adafruit/Adafruit-NAU7802-PCB/Adafruit NAU7802 Breakout.brd

## EAGLE design Adafruit NAU7802 Breakout.brd (2022-05-24)

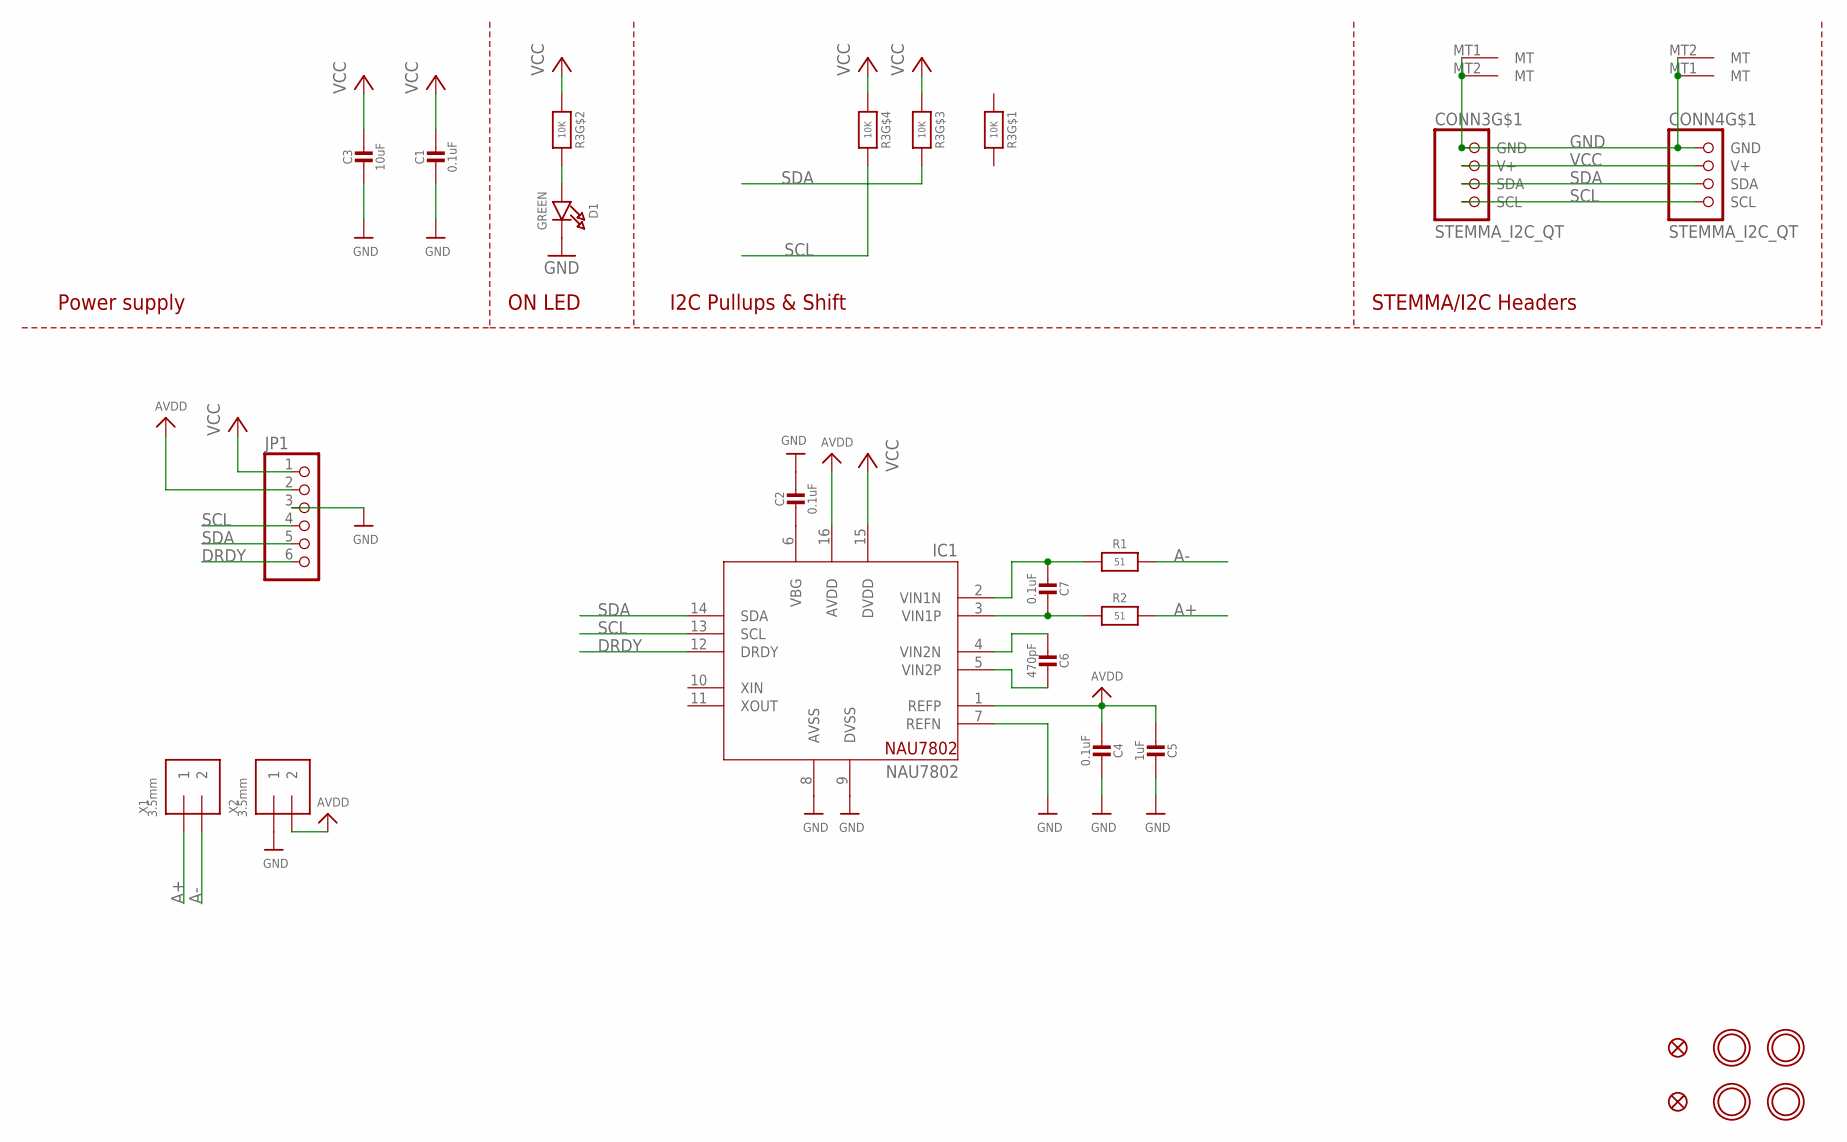
[picture p2: schematic Adafruit NAU7802 Breakout.sch]

Parts:
C1, C2, C4, C7: 0.1uF; 0603-NO
C3: 10uF; 0805-NO
C5: 1uF; 0603-NO
C6: 470pF; 0603-NO
CONN3, CONN4: STEMMA_I2C_QT; JST_SH4
D1: GREEN; CHIPLED_0603_NOOUTLINE
FID3, FID4: FIDUCIAL_1MM
IC1: NAU7802; SOIC16_NARROW
JP1: HEADER-1X670MIL; 1X06_ROUND_70
R1, R2: 51; 0603-NO
R3: 10K; RESPACK_4X0603
U$1, U$17, U$19, U$21: MOUNTINGHOLE2.5; MOUNTINGHOLE_2.5_PLATED
X1, X2: 3.5mm; TERMBLOCK_1X2-3.5MM

Connections:
A+: R2.2, X1.1
A-: R1.2, X1.2
AVDD: C4.2, C5.2, IC1.1 (REFP), IC1.16 (AVDD), JP1.2, X2.2
DRDY: IC1.12 (DRDY), JP1.6
GND: C1.2, C2.1, C3.2, C4.1, C5.1, CONN3.1 (GND), CONN3.MT1 (MT), CONN3.MT2 (MT), CONN4.1 (GND), CONN4.MT1 (MT), CONN4.MT2 (MT), D1.C, IC1.7 (REFN), IC1.8 (AVSS), IC1.9 (DVSS), JP1.3, X2.1
unnamed: D1.A, R3.7 (2)
unnamed: C2.2, IC1.6 (VBG)
unnamed: C6.2, IC1.4 (VIN2N)
unnamed: C6.1, IC1.5 (VIN2P)
unnamed: C7.1, IC1.3 (VIN1P), R2.1
unnamed: C7.2, IC1.2 (VIN1N), R1.1
SCL: CONN3.4 (SCL), CONN4.4 (SCL), IC1.13 (SCL), JP1.4, R3.5 (2)
SDA: CONN3.3 (SDA), CONN4.3 (SDA), IC1.14 (SDA), JP1.5, R3.6 (2)
VCC: C1.1, C3.1, CONN3.2 (V+), CONN4.2 (V+), IC1.15 (DVDD), JP1.1, R3.2 (1), R3.3 (1), R3.4 (1)

Notes on the sheet:
I2C Pullups & Shift
STEMMA/I2C Headers
ON LED
Power supply

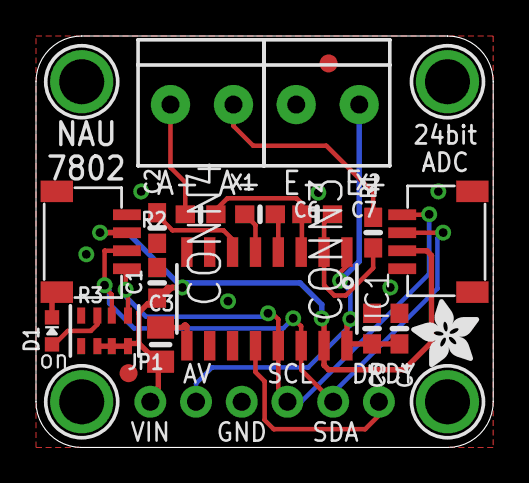
[picture p3: board Adafruit NAU7802 Breakout.brd from above]

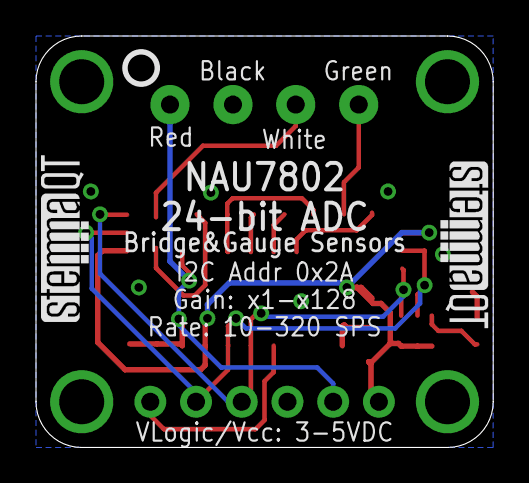
[picture p4: board Adafruit NAU7802 Breakout.brd from below]

Board: 2 copper layers, 25.4 x 22.9 mm, 27 parts (3 on the bottom side), 14 nets.

Other parts of the board:
U$22: ADAFRUIT_3.5MM
U$25: PCBFEAT-REV-040
U$30, U$31: STEMMAQT
