adafruit/Adafruit-NAU7802-PCB/(commit log)

2022-05-24 Adding cookiecutter output
    Adding schematic, board file and cookiecutter output
    [Adafruit NAU7802 board file.brd, Adafruit NAU7802 schematic.sch]
2023-02-01 updating name
    [Adafruit NAU7802 Breakout.brd, Adafruit NAU7802 Breakout.sch]
